1vers1on/vr_trackers/(list of files, cad)

Other CAD files:
models/vr_trackers_case.f3z
