1vers1on/vr_trackers/vr_trackers.kicad_pcb

## KiCad design vr_trackers.kicad_pcb (2026-03-13)

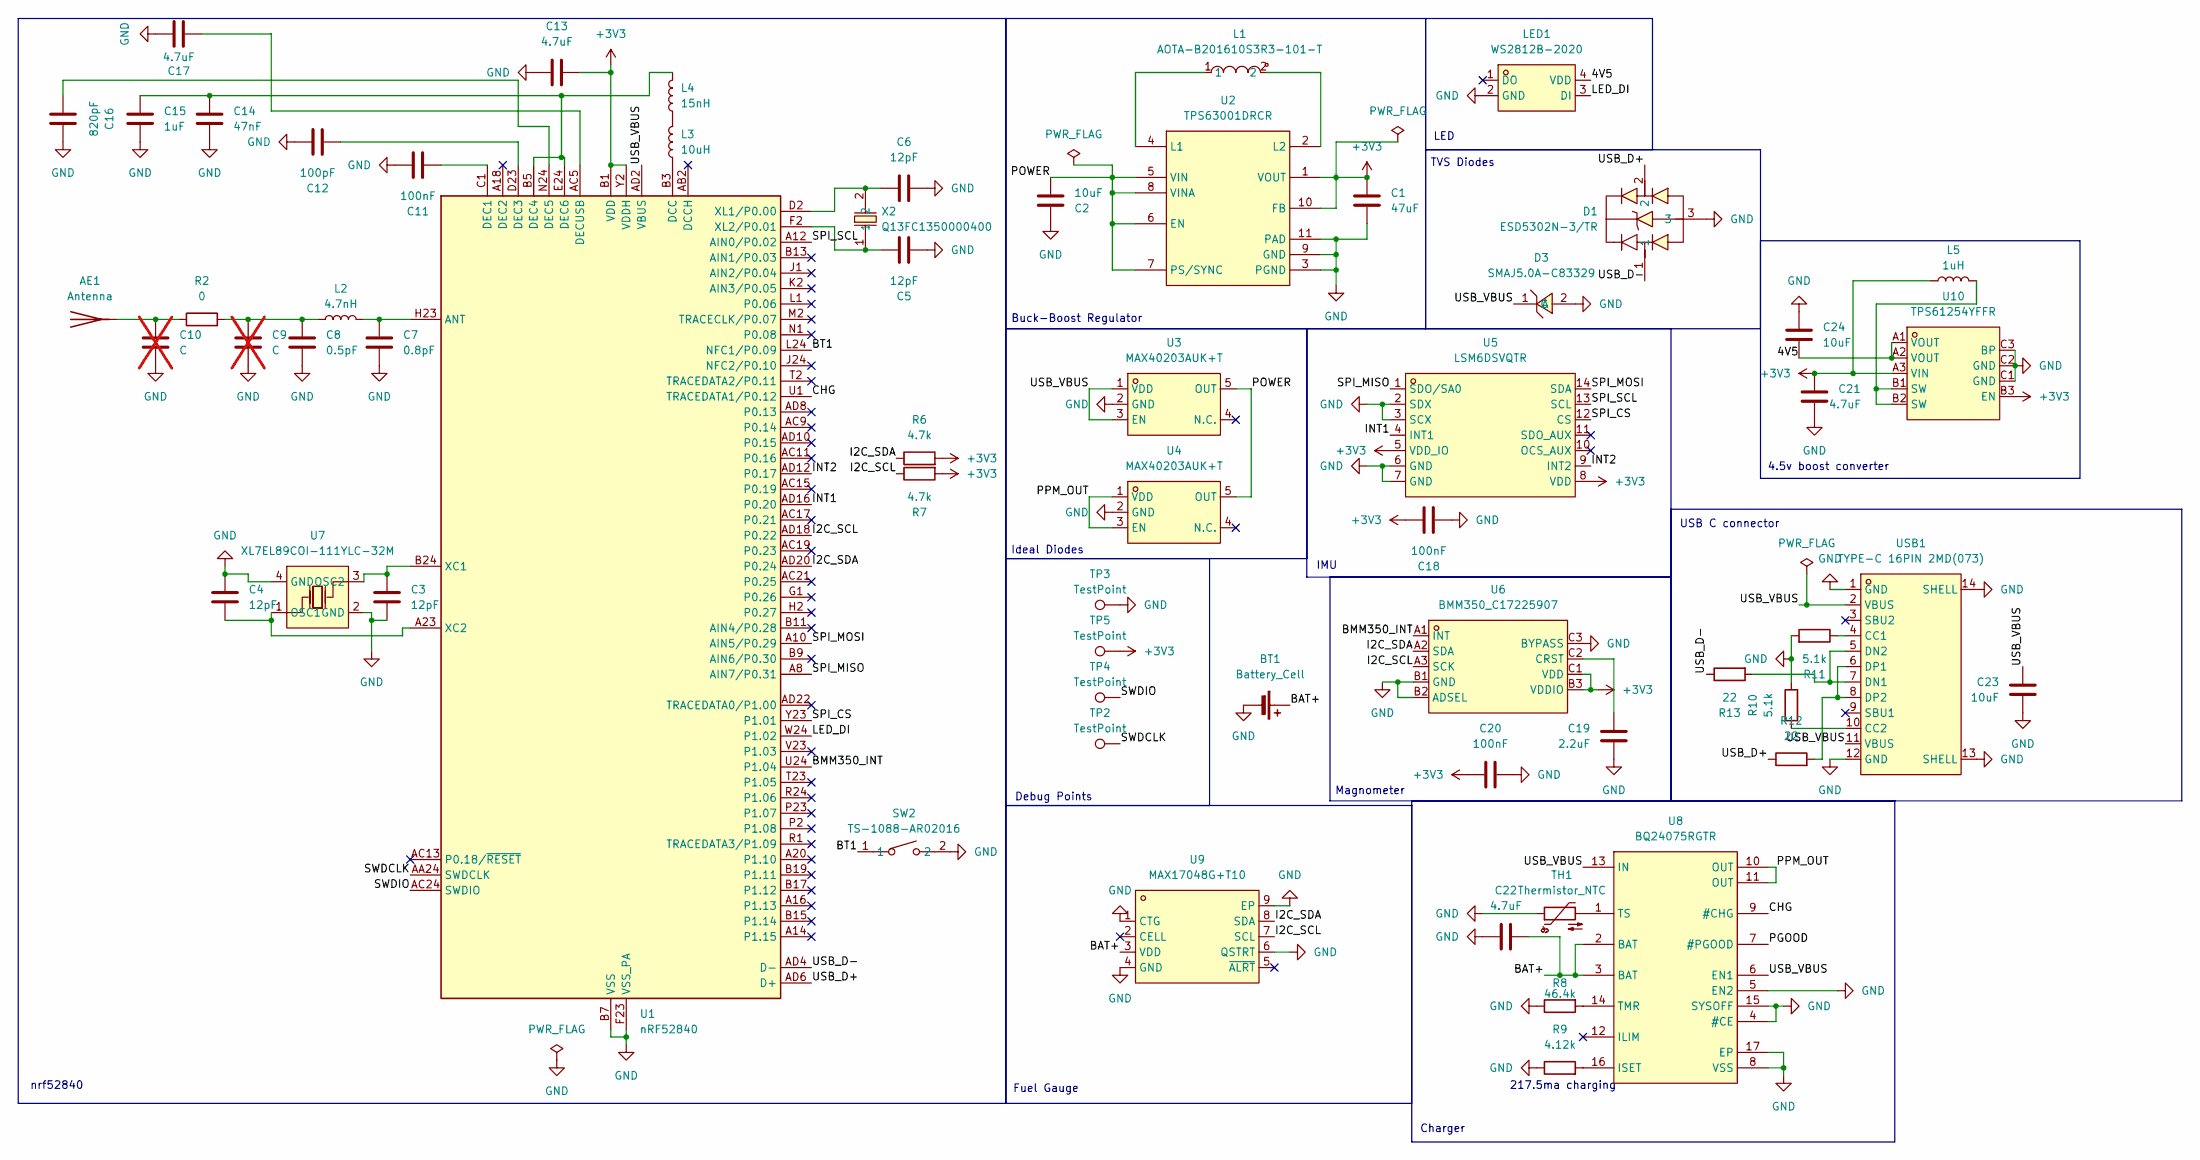
[picture p1: schematic vr_trackers.kicad_sch]

Parts:
AE1: Antenna; TI_DN007_2.4GHz
BT1: Battery_Cell; PinHeader_2x01_P2.54mm_Vertical
C1: 47uF; C_0603_1608Metric; LCSC Part C140782
C2, C23: 10uF; C_0402_1005Metric; LCSC Part C315248
C3, C4, C5, C6: 12pF; C_0402_1005Metric; LCSC Part C76948
C7: 0.8pF; C_0402_1005Metric; LCSC Part C327032
C8: 0.5pF; C_0402_1005Metric; LCSC Part C76912
C9, C10: C; C_0402_1005Metric; not fitted
C11, C18, C20: 100nF; C_0402_1005Metric; LCSC Part C60474
C12: 100pF; C_0402_1005Metric; LCSC Part C106200
C13, C17, C22: 4.7uF; C_0402_1005Metric; LCSC Part C23733
C14: 47nF; C_0402_1005Metric; LCSC Part C368599
C15: 1uF; C_0402_1005Metric; LCSC Part C14445
C16: 820pF; C_0402_1005Metric; LCSC Part C161159
C19: 2.2uF; C_0402_1005Metric; LCSC Part C170151
C21: 4.7uF; C_0402_1005Metric
C24: 10uF; C_0402_1005Metric
D1: ESD5302N-3/TR; DFN1006-3L_L1.0-W0.6-P0.35-BL-A; LCSC Part C239822
D3: SMAJ5.0A-C83329; SMA_L4.3-W2.6-LS5.2-RD; LCSC Part C83329
L1: AOTA-B201610S3R3-101-T; IND-SMD_L2.0-W1.6_AOTA-B201610S3R3-101-T; LCSC Part C42411119
L2: 4.7nH; L_0402_1005Metric; LCSC Part C395070
L3: 10uH; L_0603_1608Metric; LCSC Part C76798
L4: 15nH; L_0402_1005Metric; LCSC Part C86059
L5: 1uH; L_0402_1005Metric
LED1: WS2812B-2020; LED-SMD_4P-L2.0-W2.0-TL_WS2812B-2020; LCSC Part C965555
R2: 0; R_0402_1005Metric; LCSC Part C106231
R6, R7: 4.7k; R_0402_1005Metric; LCSC Part C105871
R8: 46.4k; R_0402_1005Metric; LCSC Part C5126026
R9: 4.12k; R_0402_1005Metric; LCSC Part C2480411
R10, R11: 5.1k; R_0402_1005Metric; LCSC Part C105872
R12, R13: 22; R_0402_1005Metric; LCSC Part C114765
SW2: TS-1088-AR02016; SW-SMD_L3.9-W3.0-P4.45; LCSC Part C720477
TH1: Thermistor_NTC; R_0402_1005Metric; LCSC Part C77131
TP2, TP3, TP4, TP5: TestPoint; TestPoint_THTPad_D1.0mm_Drill0.5mm
U1: nRF52840; Nordic_AQFN-73-1EP_7x7mm_P0.5mm; LCSC Part C190794
U2: TPS63001DRCR; VSON-10_L3.0-W3.0-P0.50-TL-EP_TPS62410DRCR; LCSC Part C28060
U3, U4: MAX40203AUK+T; SOT-23-5_L3.0-W1.6-P0.95-LS2.8-BR; LCSC Part C2653639
U5: LSM6DSVQTR; LGA-14_L3.0-W2.5-P0.50-TL; LCSC Part C17496470
U6: BMM350_C17225907; WLCSP-9_L1.3-W1.3-R3-C3-P0.40-TL; LCSC Part C17225907
U7: XL7EL89COI-111YLC-32M; CRYSTAL-SMD_4P-L2.0-W1.6-BL-2; LCSC Part C2965584
U8: BQ24075RGTR; QFN-16_L3.0-W3.0-P0.50-TL-EP1.7; LCSC Part C15464
U9: MAX17048G+T10; TDFN-8_L2.0-W2.0-P0.50-BL-EP1.2; LCSC Part C2682616
U10: TPS61254YFFR; DSBGA-9_L1.3-W1.3-R3-C3-P0.40-BL; LCSC Part C2863435
USB1: TYPE-C 16PIN 2MD(073); USB-C-SMD_TYPE-C-6PIN-2MD-073; LCSC Part C2765186
X2: Q13FC1350000400; FC-135R_L3.2-W1.5; LCSC Part C32346

Connections:
+3V3: C1.1, C13.1, C18.1, C20.2, C21.2, L5.1, R6.2, R7.2, TP5.1, U1.A22 (VDD), U1.AD14 (VDD), U1.AD23 (VDD), U1.B1 (VDD), U1.W1 (VDD), U1.Y2 (VDDH), U2.1 (VOUT), U2.10 (FB), U5.5 (VDD_IO), U5.8 (VDD), U6.B3 (VDDIO), U6.C1 (VDD), U10.A3 (VIN), U10.B3 (EN)
/4V5: C24.2, LED1.4 (VDD), U10.A1 (VOUT), U10.A2 (VOUT)
/BAT+: BT1.1 (+), C22.1, U8.2 (BAT), U8.3 (BAT), U9.3 (VDD)
/BMM350_INT: U1.U24 (P1.04), U6.A1 (INT)
/BT1: SW2.1, U1.L24 (NFC1/P0.09)
/CHG: U1.U1 (TRACEDATA1/P0.12), U8.9 (#CHG)
/I2C_SCL: R7.1, U1.AD18 (P0.22), U6.A3 (SCK), U9.7 (SCL)
/I2C_SDA: R6.1, U1.AD20 (P0.24), U6.A2 (SDA), U9.8 (SDA)
/INT1: U1.AD16 (P0.20), U5.4 (INT1)
/INT2: U1.AD12 (P0.17), U5.9 (INT2)
/LED_DI: LED1.3 (DI), U1.W24 (P1.02)
/PGOOD: U8.7 (#PGOOD)
/POWER: C2.2, U2.5 (VIN), U2.6 (EN), U2.7 (PS/SYNC), U2.8 (VINA), U3.5 (OUT), U4.5 (OUT)
/PPM_OUT: U4.1 (VDD), U4.3 (EN), U8.10 (OUT), U8.11 (OUT)
/SPI_CS: U1.Y23 (P1.01), U5.12 (CS)
/SPI_MISO: U1.A8 (AIN7/P0.31), U5.1 (SDO/SA0)
/SPI_MOSI: U1.A10 (AIN5/P0.29), U5.14 (SDA)
/SPI_SCL: U1.A12 (AIN0/P0.02), U5.13 (SCL)
/SWDCLK: TP2.1, U1.AA24 (SWDCLK)
/SWDIO: TP4.1, U1.AC24 (SWDIO)
/USB_D+: D1.2, R12.1, U1.AD6 (D+)
/USB_D-: D1.1, R13.1, U1.AD4 (D-)
/USB_VBUS: C23.1, D3.1 (C), U1.AD2 (VBUS), U3.1 (VDD), U3.3 (EN), U8.6 (EN1), U8.13 (IN), USB1.2 (VBUS), USB1.11 (VBUS)
GND: AE1.2, BT1.2 (-), C1.2, C2.1, C3.2, C4.1, C5.2, C6.2, C7.1, C8.1, C9.2, C10.2, C11.1, C12.1, C13.2, C14.2, C15.2, C16.1, C17.1, C18.2, C19.1, C20.1, C21.1, C22.2, C23.2, C24.1, D1.3, D3.2 (A), LED1.2 (GND), R8.1, R9.1, R10.1, R11.2, SW2.2, TH1.1, TP3.1, U1.B7 (VSS), U1.EP (VSS), U1.F23 (VSS_PA), U2.3 (PGND), U2.9 (GND), U2.11 (PAD), U3.2 (GND), U4.2 (GND), U5.2 (SDX), U5.3 (SCX), U5.6 (GND), U5.7 (GND), U6.B1 (GND), U6.B2 (ADSEL), U6.C3 (BYPASS), U7.2 (GND), U7.4 (GND), U8.4 (#CE), U8.5 (EN2), U8.8 (VSS), U8.15 (SYSOFF), U8.17 (EP), U9.1 (CTG), U9.4 (GND), U9.6 (QSTRT), U9.9 (EP), U10.C1 (GND), U10.C2 (GND), U10.C3 (BP), USB1.1 (GND), USB1.12 (GND), USB1.13 (SHELL), USB1.14 (SHELL)
unnamed: AE1.1 (A), C10.1, R2.1
unnamed: C8.2, C9.1, L2.1, R2.2
unnamed: L3.2, L4.1
unnamed: L5.2, U10.B1 (SW), U10.B2 (SW)
unnamed: C7.2, L2.2, U1.H23 (ANT)
unnamed: L3.1, U1.B3 (DCC)
unnamed: C11.2, U1.C1 (DEC1)
unnamed: C12.2, U1.D23 (DEC3)
unnamed: C14.1, C15.1, L4.2, U1.B5 (DEC4), U1.E24 (DEC6)
unnamed: C16.2, U1.N24 (DEC5)
unnamed: C17.2, U1.AC5 (DECUSB)
unnamed: C3.1, U1.B24 (XC1), U7.3 (OSC2)
unnamed: C4.2, U1.A23 (XC2), U7.1 (OSC1)
unnamed: C6.1, U1.D2 (XL1/P0.00), X2.2
unnamed: C5.1, U1.F2 (XL2/P0.01), X2.1
unnamed: L1.1, U2.4 (L1)
unnamed: L1.2, U2.2 (L2)
unnamed: C19.2, U6.C2 (CRST)
unnamed: R9.2, U8.16 (ISET)
unnamed: R8.2, U8.14 (TMR)
unnamed: TH1.2, U8.1 (TS)
unnamed: R11.1, USB1.4 (CC1)
unnamed: R10.2, USB1.10 (CC2)
unnamed: R13.2, USB1.5 (DN2), USB1.7 (DN1)
unnamed: R12.2, USB1.6 (DP1), USB1.8 (DP2)

Notes on the sheet:
Fuel Gauge
Magnometer
4.5v boost converter
nrf52840
USB C connector
Charger
LED
Ideal Diodes
TVS Diodes
Buck-Boost Regulator
IMU
217.5ma charging
Debug Points

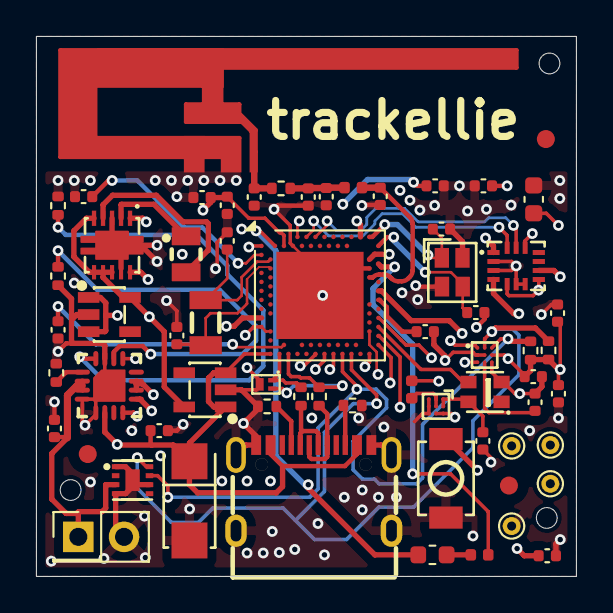
[picture p2: board vr_trackers.kicad_pcb from above]

Board: 4 copper layers, 30.0 x 30.0 mm, 61 parts (0 on the bottom side), 48 nets.
