1vers1on/vr_trackers/swd_adapter/swd_adapter.kicad_pcb

## KiCad design swd_adapter/swd_adapter.kicad_pcb (2026-03-12)

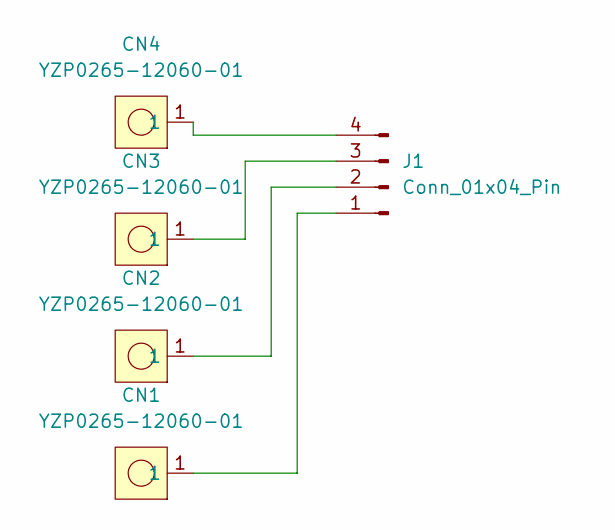
[picture p3: schematic swd_adapter.kicad_sch]

Parts:
CN1, CN2, CN3, CN4: YZP0265-12060-01; CONN-TH_YZP0265-12060-01; LCSC Part C5157236
J1: Conn_01x04_Pin; PinHeader_1x04_P2.54mm_Vertical

Connections:
unnamed: CN1.1, J1.1
unnamed: CN2.1, J1.2
unnamed: CN3.1, J1.3
unnamed: CN4.1, J1.4

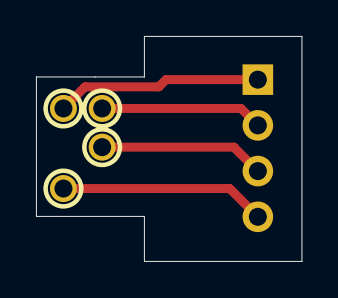
[picture p4: board swd_adapter.kicad_pcb from above]

Board: 2 copper layers, 14.8 x 12.5 mm, 5 parts (1 on the bottom side), 4 nets.
