1vers1on/vr_trackers/(commit log)

2026-03-06 First revision of the pcb i think idk when i last commited this
    [vr_trackers.kicad_pcb]
2026-03-06 Second revision of the pcb
    [vr_trackers.kicad_pcb]
2026-03-06 Fix errors
    [vr_trackers.kicad_pcb]
2026-03-06 Move the step file to a models directory
    [vr_trackers.kicad_pcb]
2026-03-08 Add stuff i forget what
    [vr_trackers.kicad_pcb, vr_trackers_case.f3z]
2026-03-12 add firmware stuff and update the pcb
    [vr_trackers.kicad_pcb, vr_trackers.kicad_sch]
2026-03-12 Update the pcb to add a 4.5v lane, add a lot to the code, and make a second pcb to help programming
    [swd_adapter.kicad_pcb, swd_adapter.kicad_sch, vr_trackers.kicad_pcb, vr_trackers.kicad_sch]
2026-03-13 give up on rust and do smth to the pcb
    [vr_trackers.kicad_pcb]
2026-03-13 switching to c++ for the software frontend
